reiserlab/LED-Display_G4_Hardware_Driver/driver_40mm_atmega_v1p9/assets/driver_40mm_atmega.step

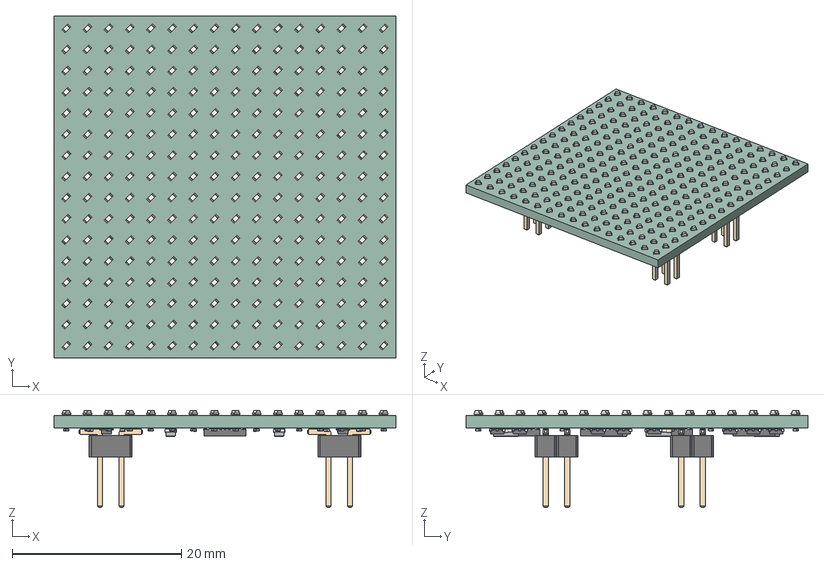
[picture p2: CAD file, 2025-07-31]
driver_40mm_atmega_v1p9/assets/driver_40mm_atmega.step
40.4 x 40.4 x 11.5 mm
LED_0402_1005Metric x 256
PinHeader_2x02_P2.54mm_Vertical_SMD x 4
QFN-32-1EP_5x5mm_P0.5mm_EP3.7x3.7mm x 4
R_0201_0603Metric x 100
SOT-563 x 16
C_0201_0603Metric x 40
Resonator_SMD_Murata_CSTxExxV-3Pin_3.0x1.1mm x 4
driver_40mm_atmega_PCB
