reiserlab/LED-Display_G4_Hardware_Driver/docs/assets/driver_40mm_atmega_v1.9_schematic.pdf

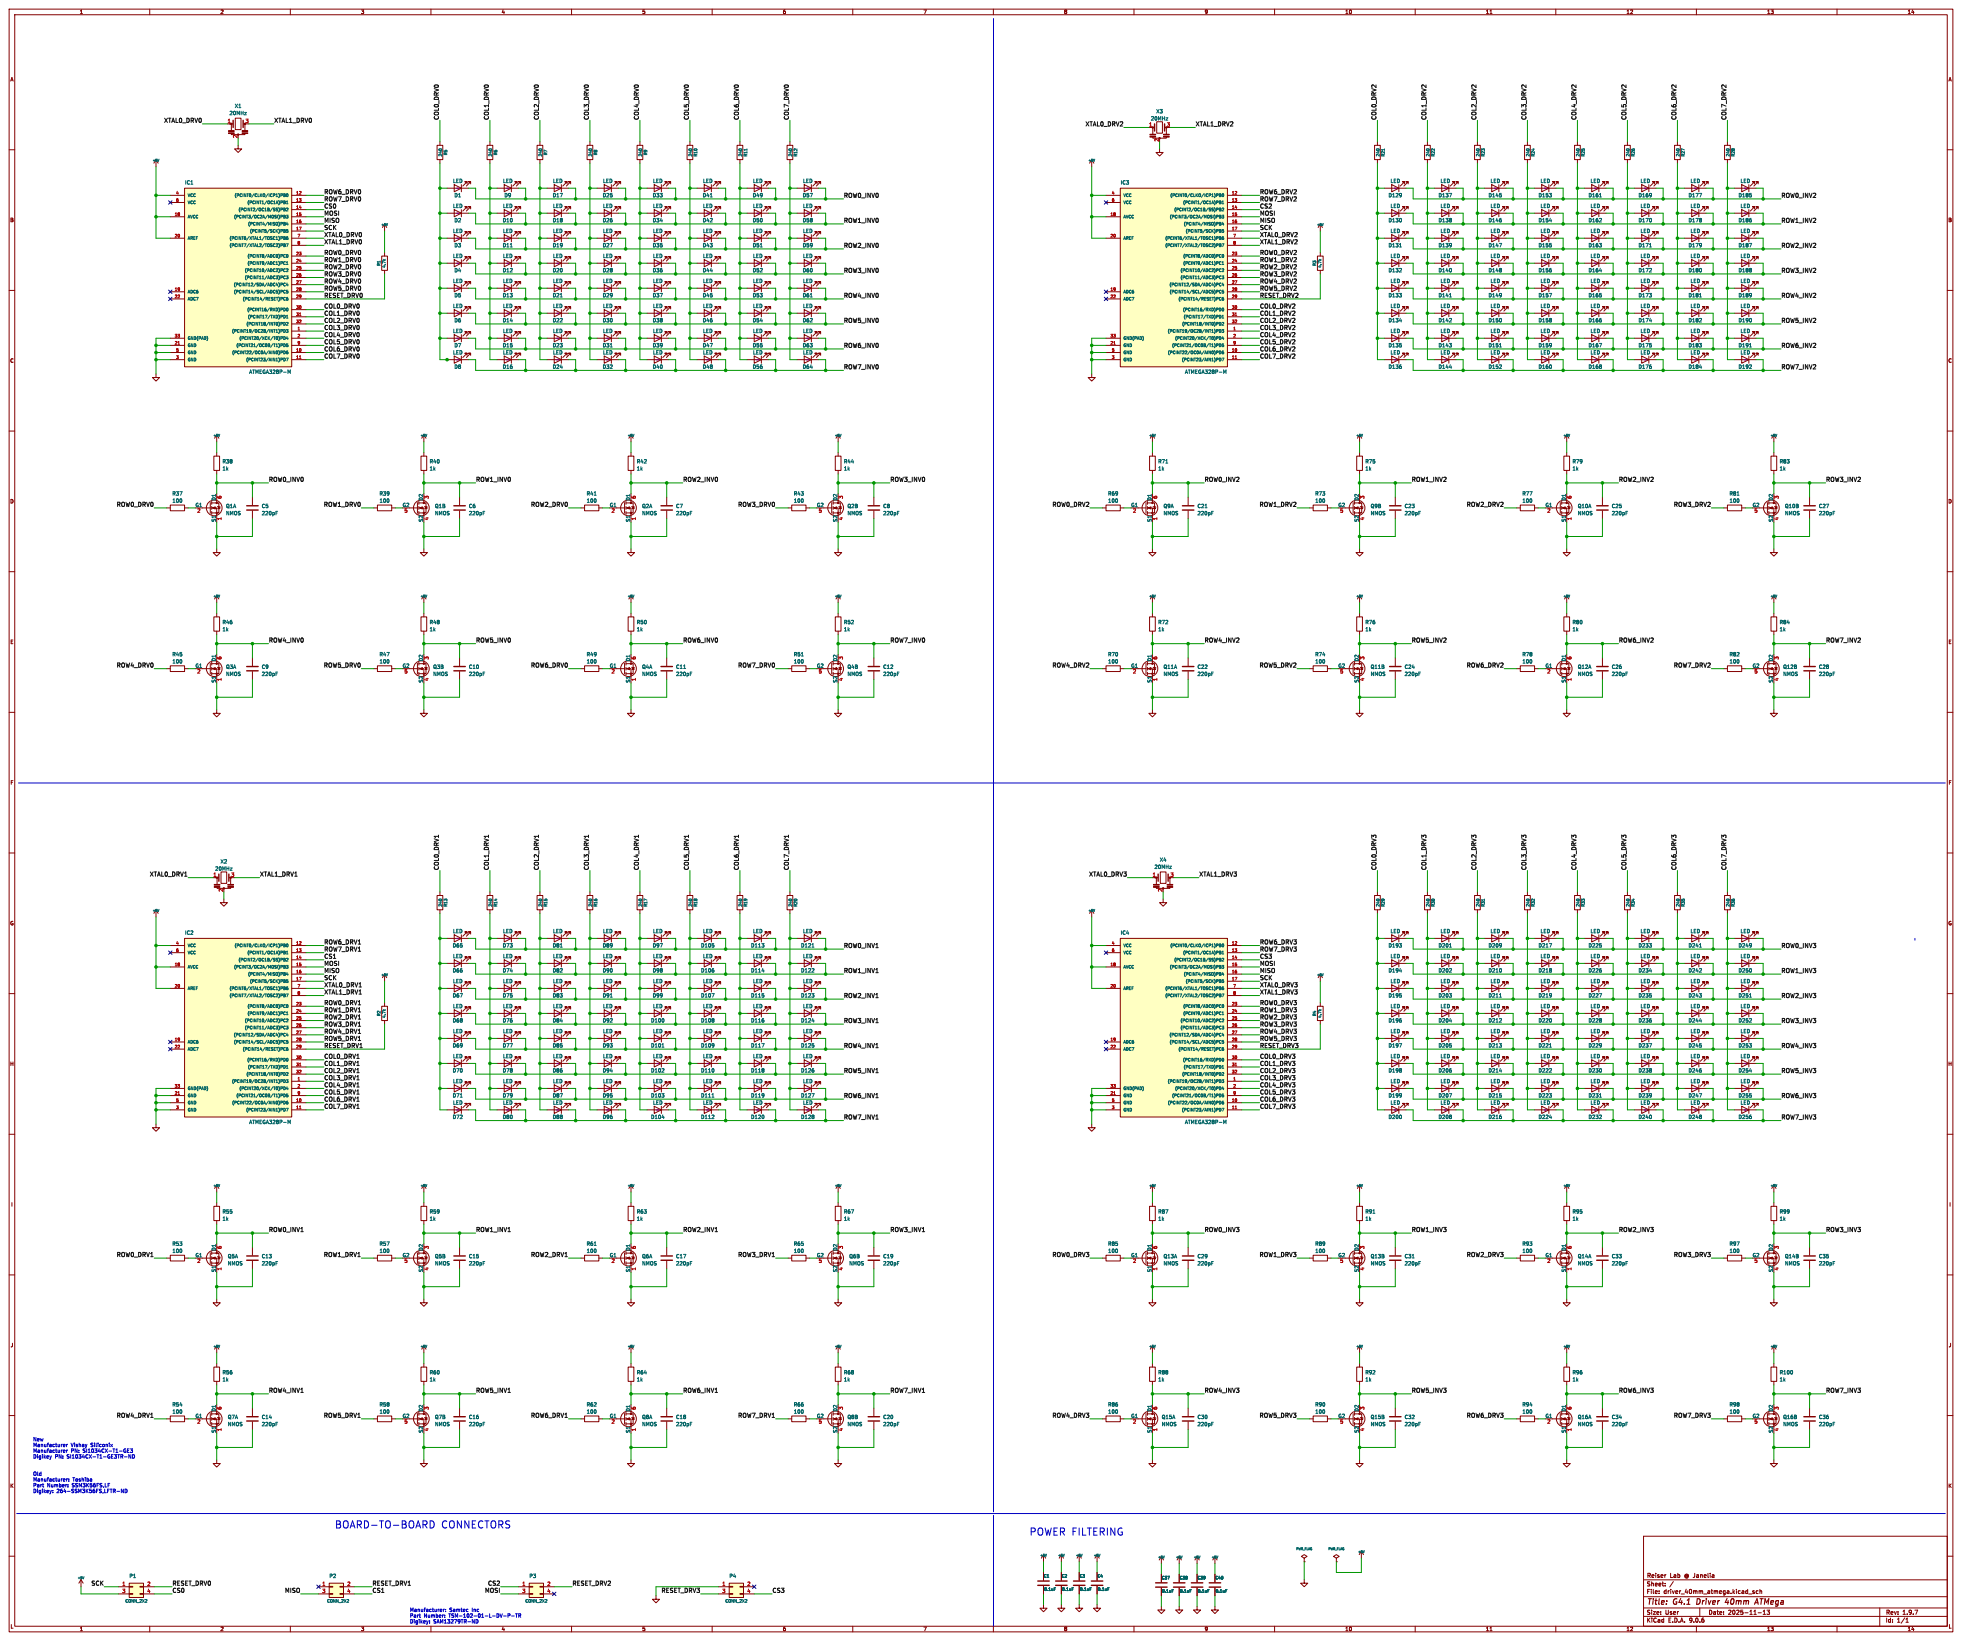
[picture p3: page 1]

Id: 1/1 Title: G4.1 Driver 40mm ATMega
