reiserlab/LED-Display_G4_Hardware_Driver/(list of files, drawings)

Other design files:
driver_40mm_atmega_v1p9/driver_40mm_atmega.dsn
