reiserlab/LED-Display_G4_Hardware_Driver/driver_40mm_atmega_v1p9/driver_40mm_atmega.kicad_pcb

## KiCad design driver_40mm_atmega_v1p9/driver_40mm_atmega.kicad_pcb (2025-11-13)

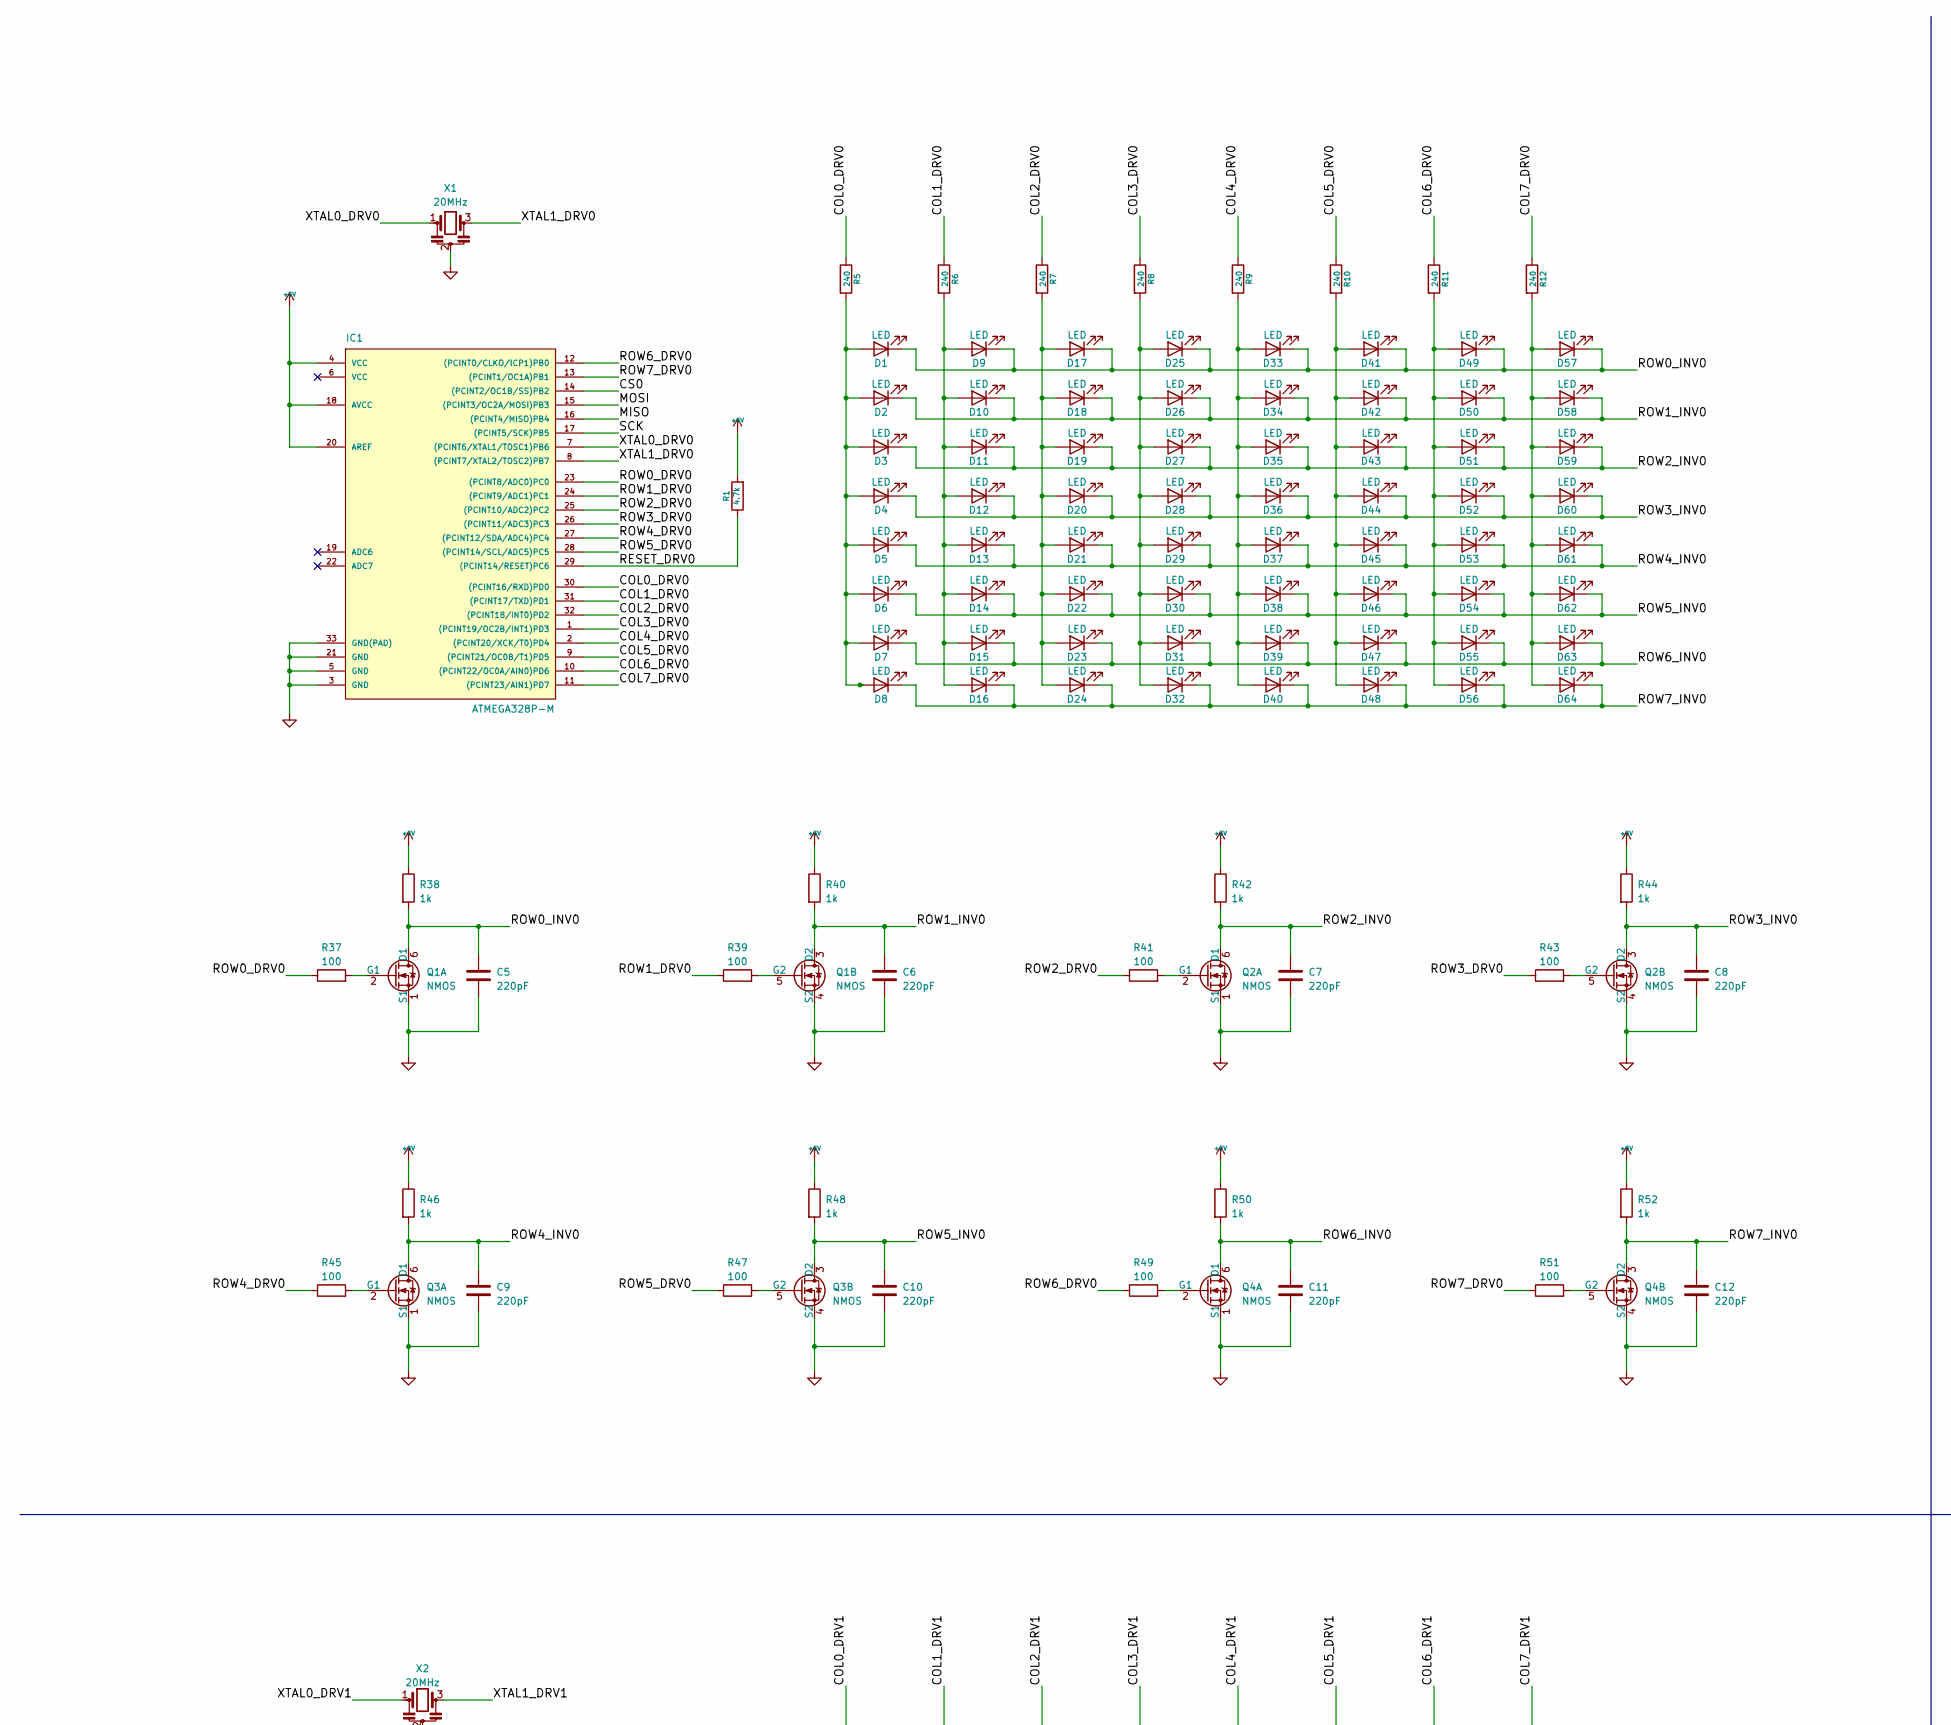
[picture p4: schematic driver_40mm_atmega.kicad_sch, G4.1 Driver 40mm ATMega, part in row 1, column 1]

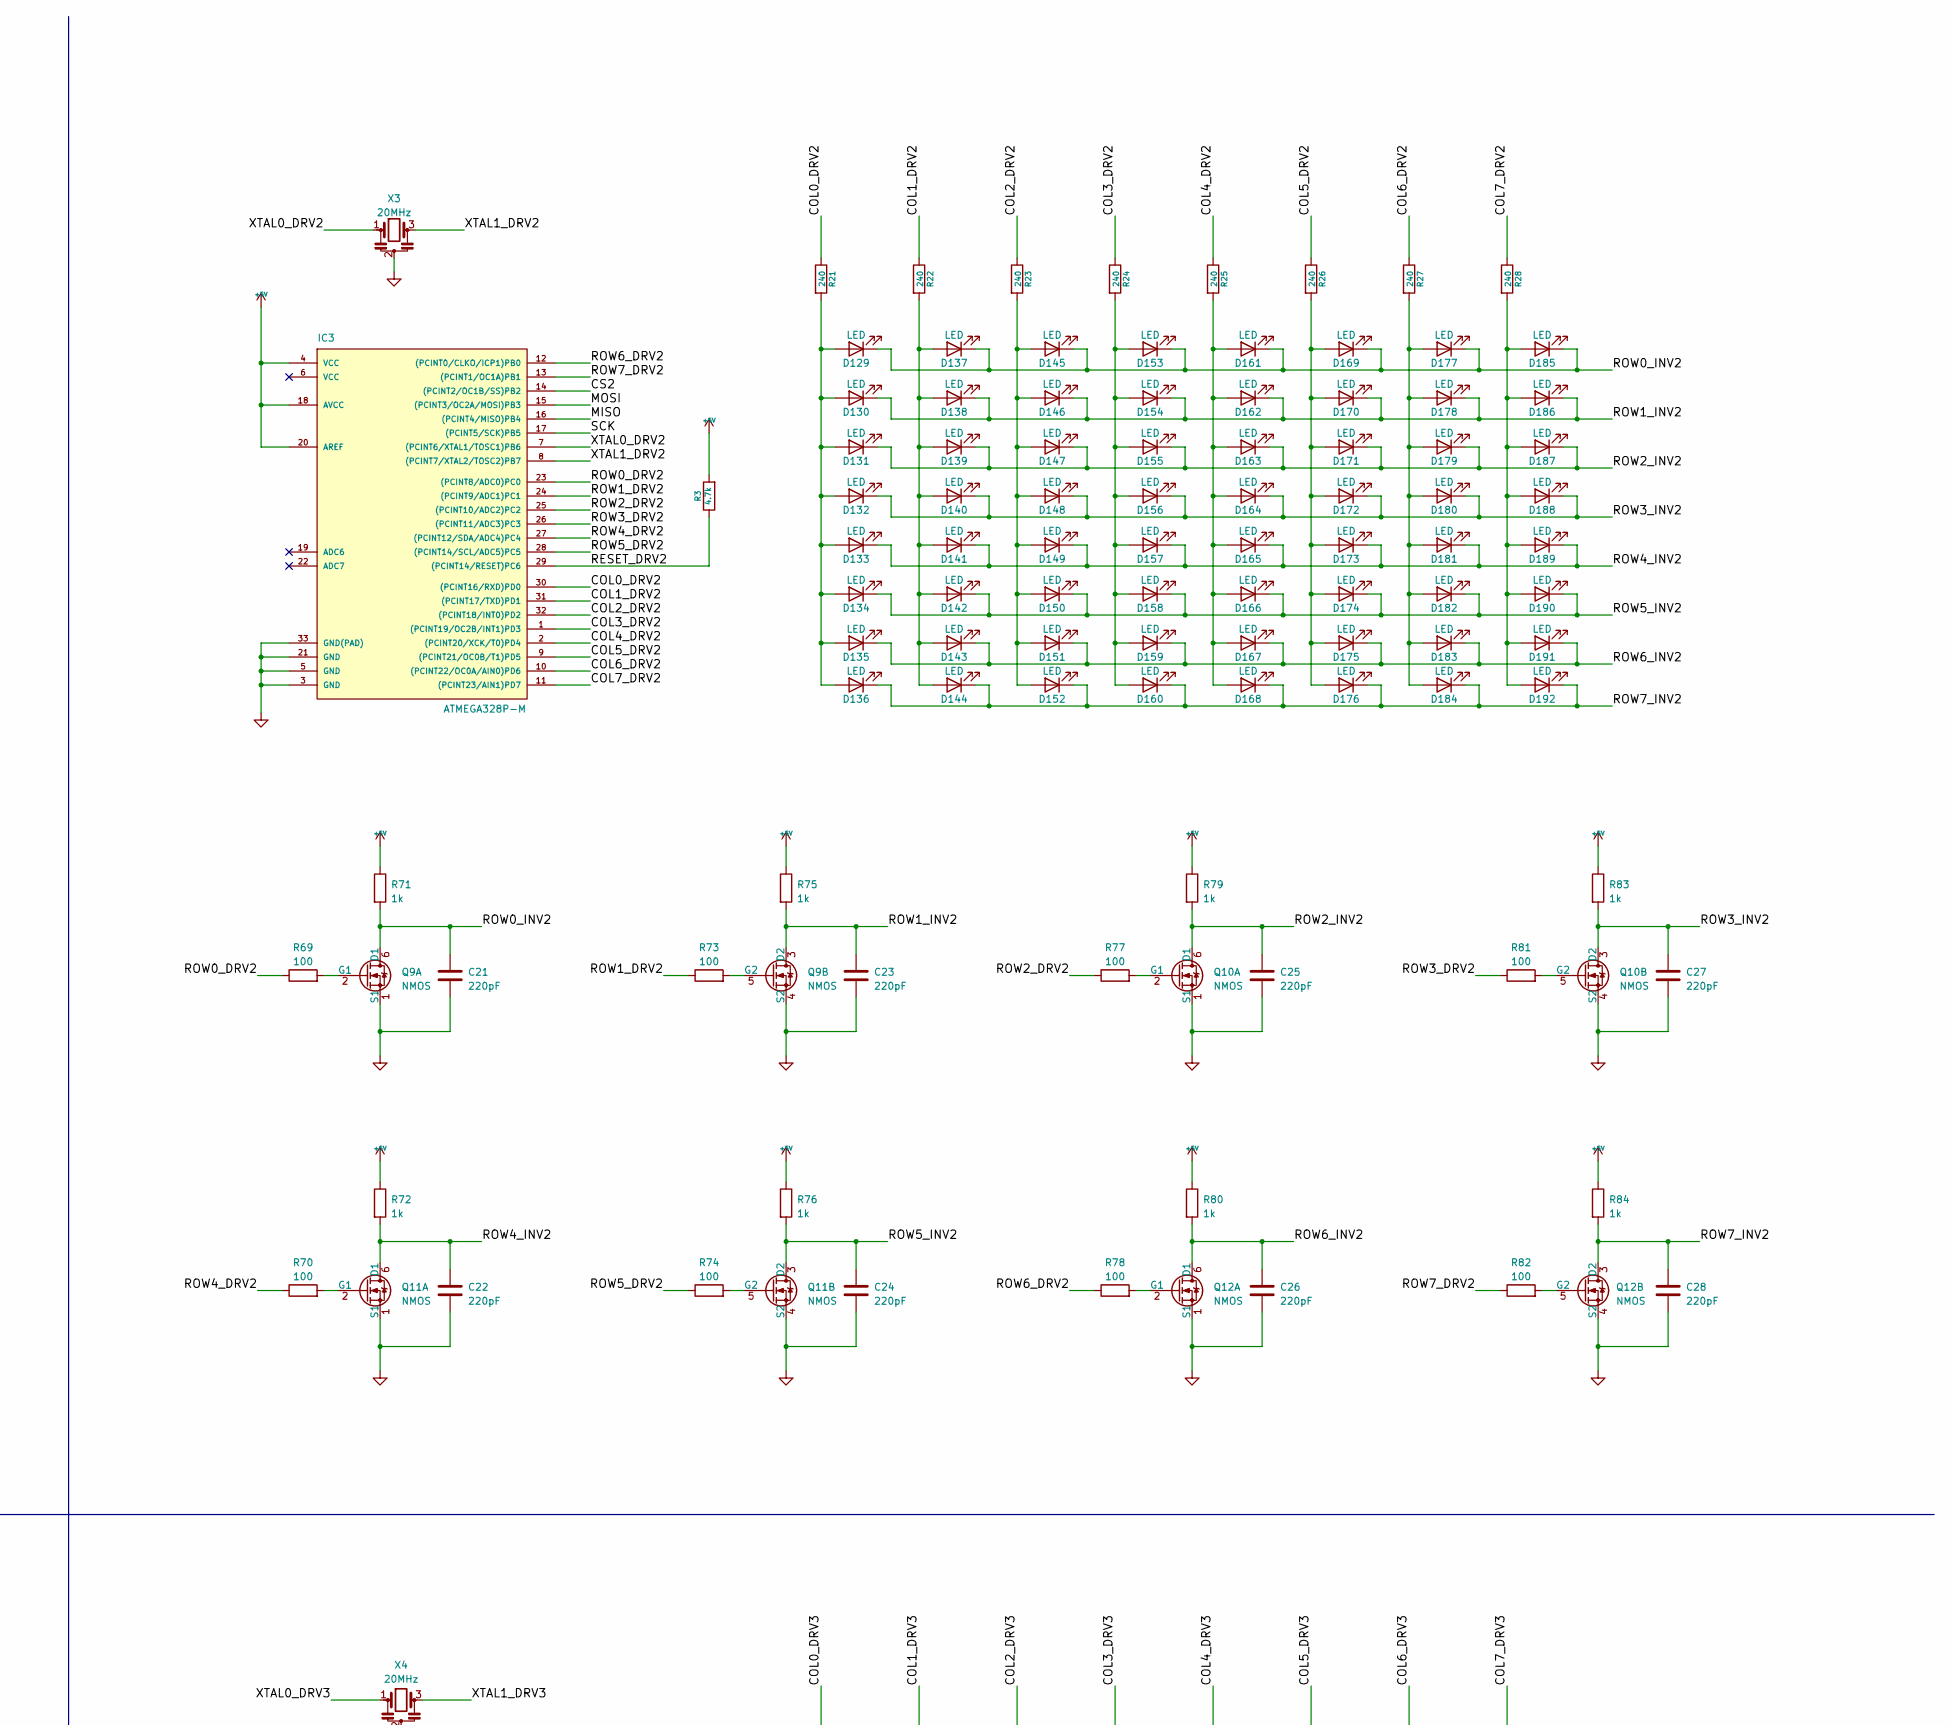
[picture p5: schematic driver_40mm_atmega.kicad_sch, G4.1 Driver 40mm ATMega, part in row 1, column 2]

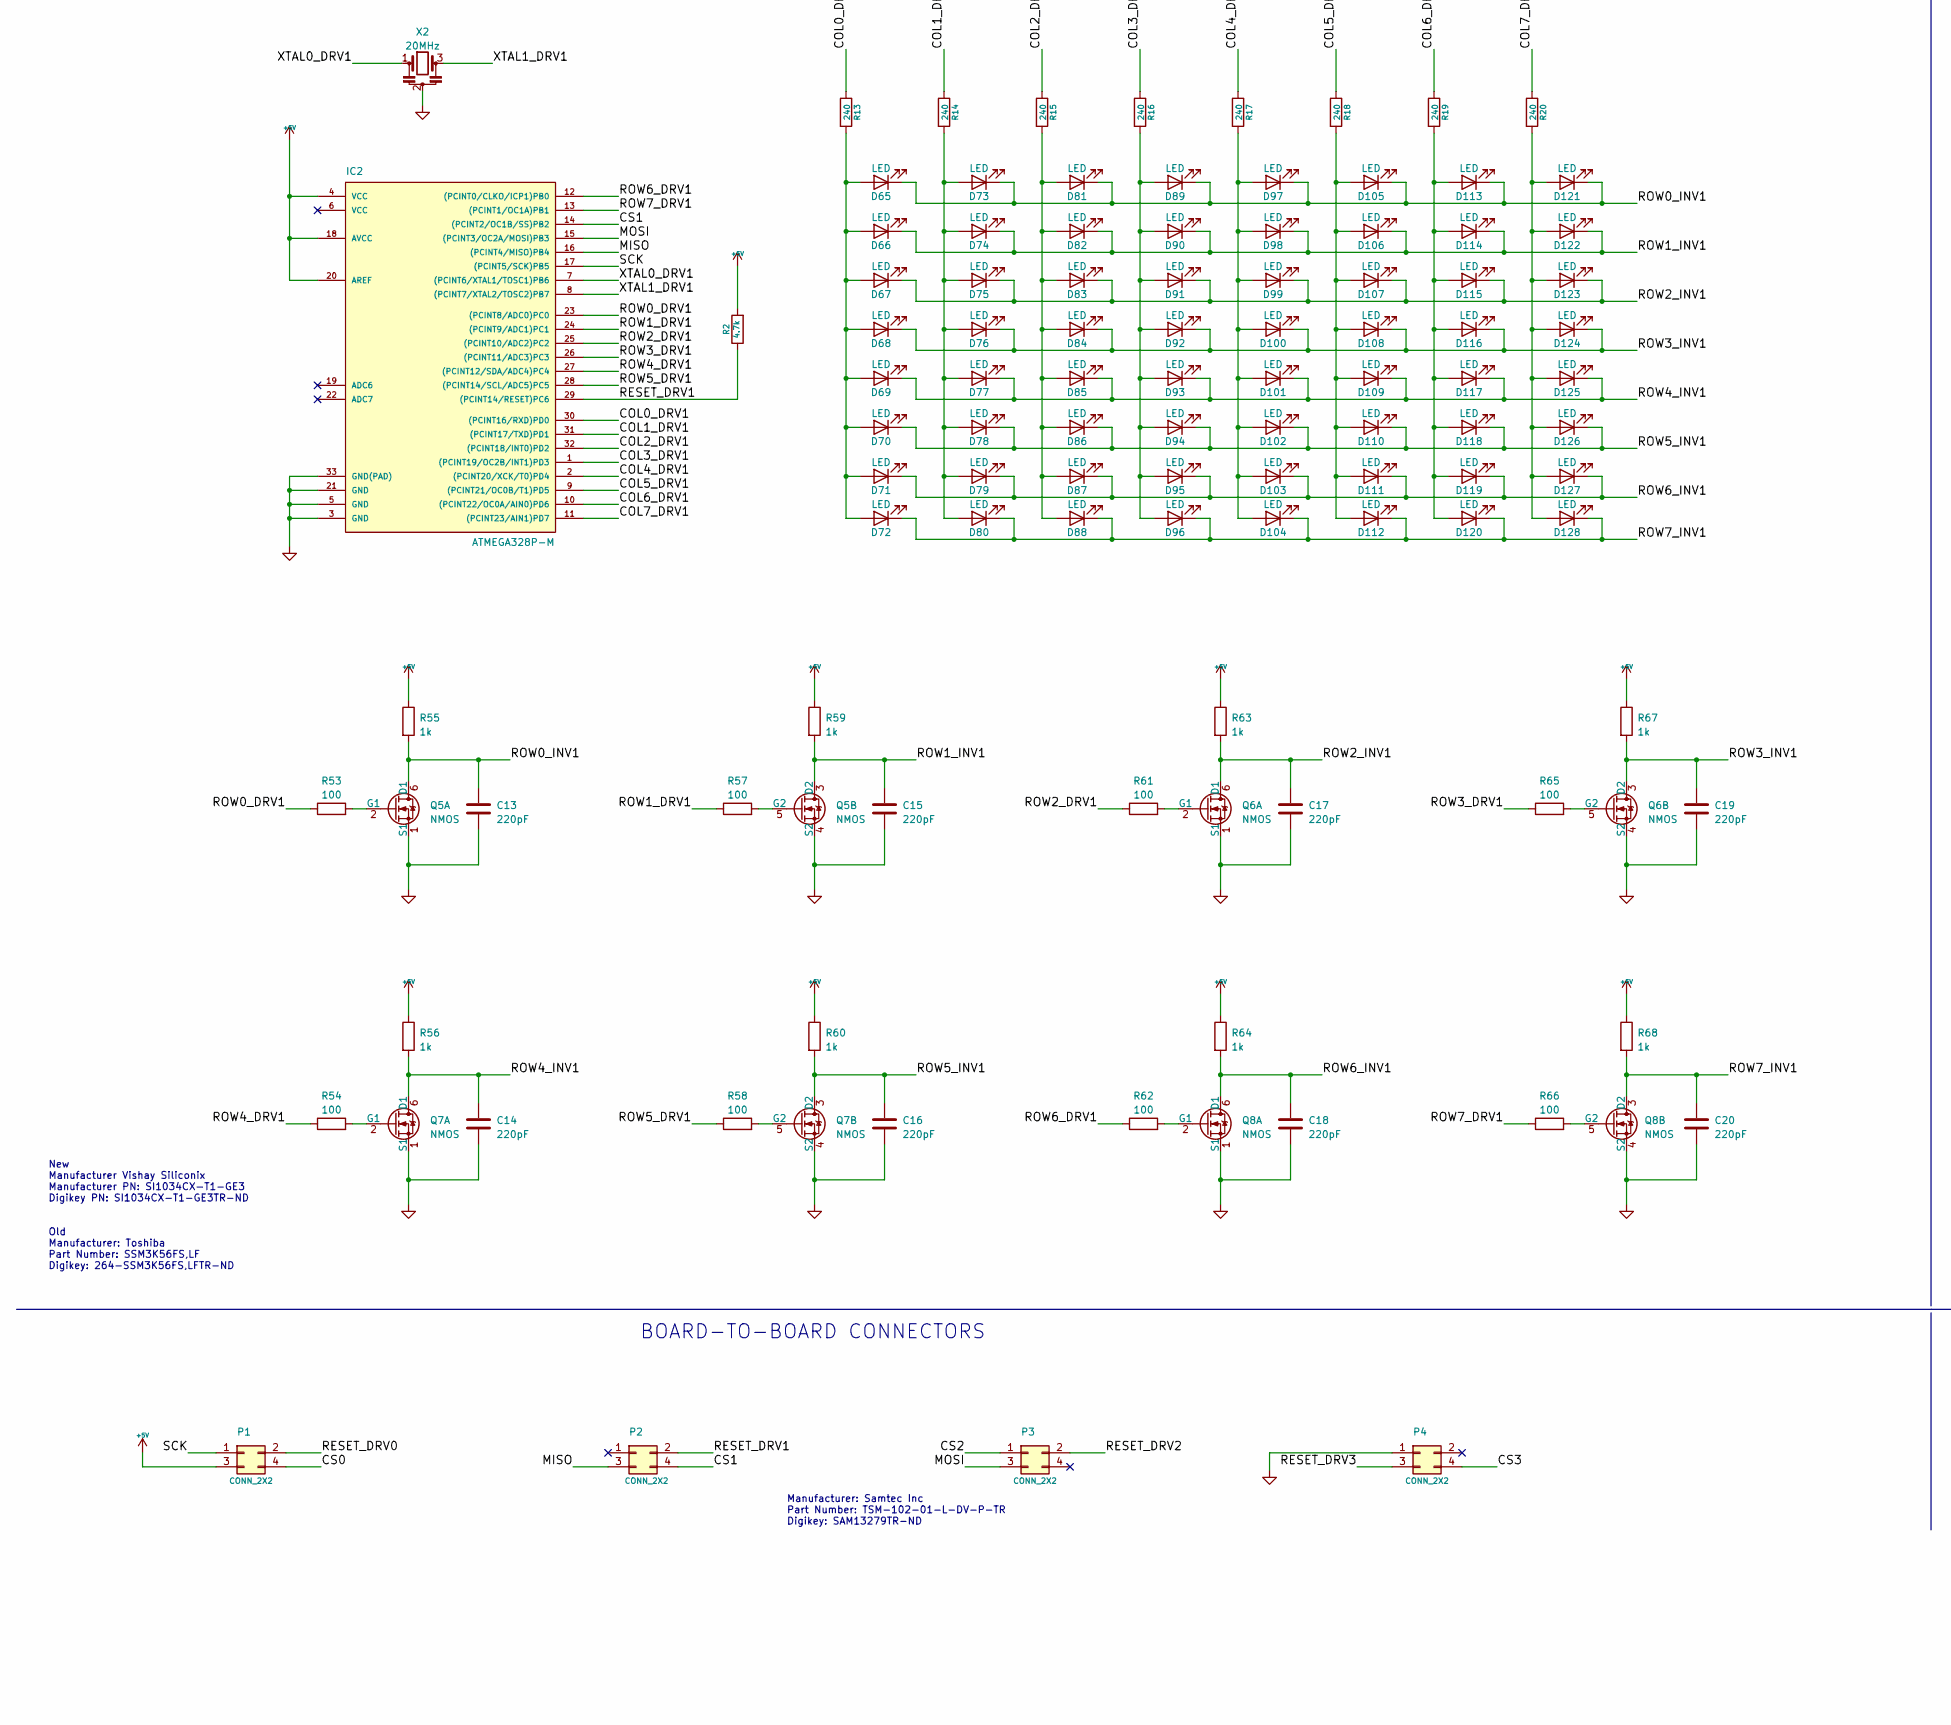
[picture p6: schematic driver_40mm_atmega.kicad_sch, G4.1 Driver 40mm ATMega, part in row 2, column 1]

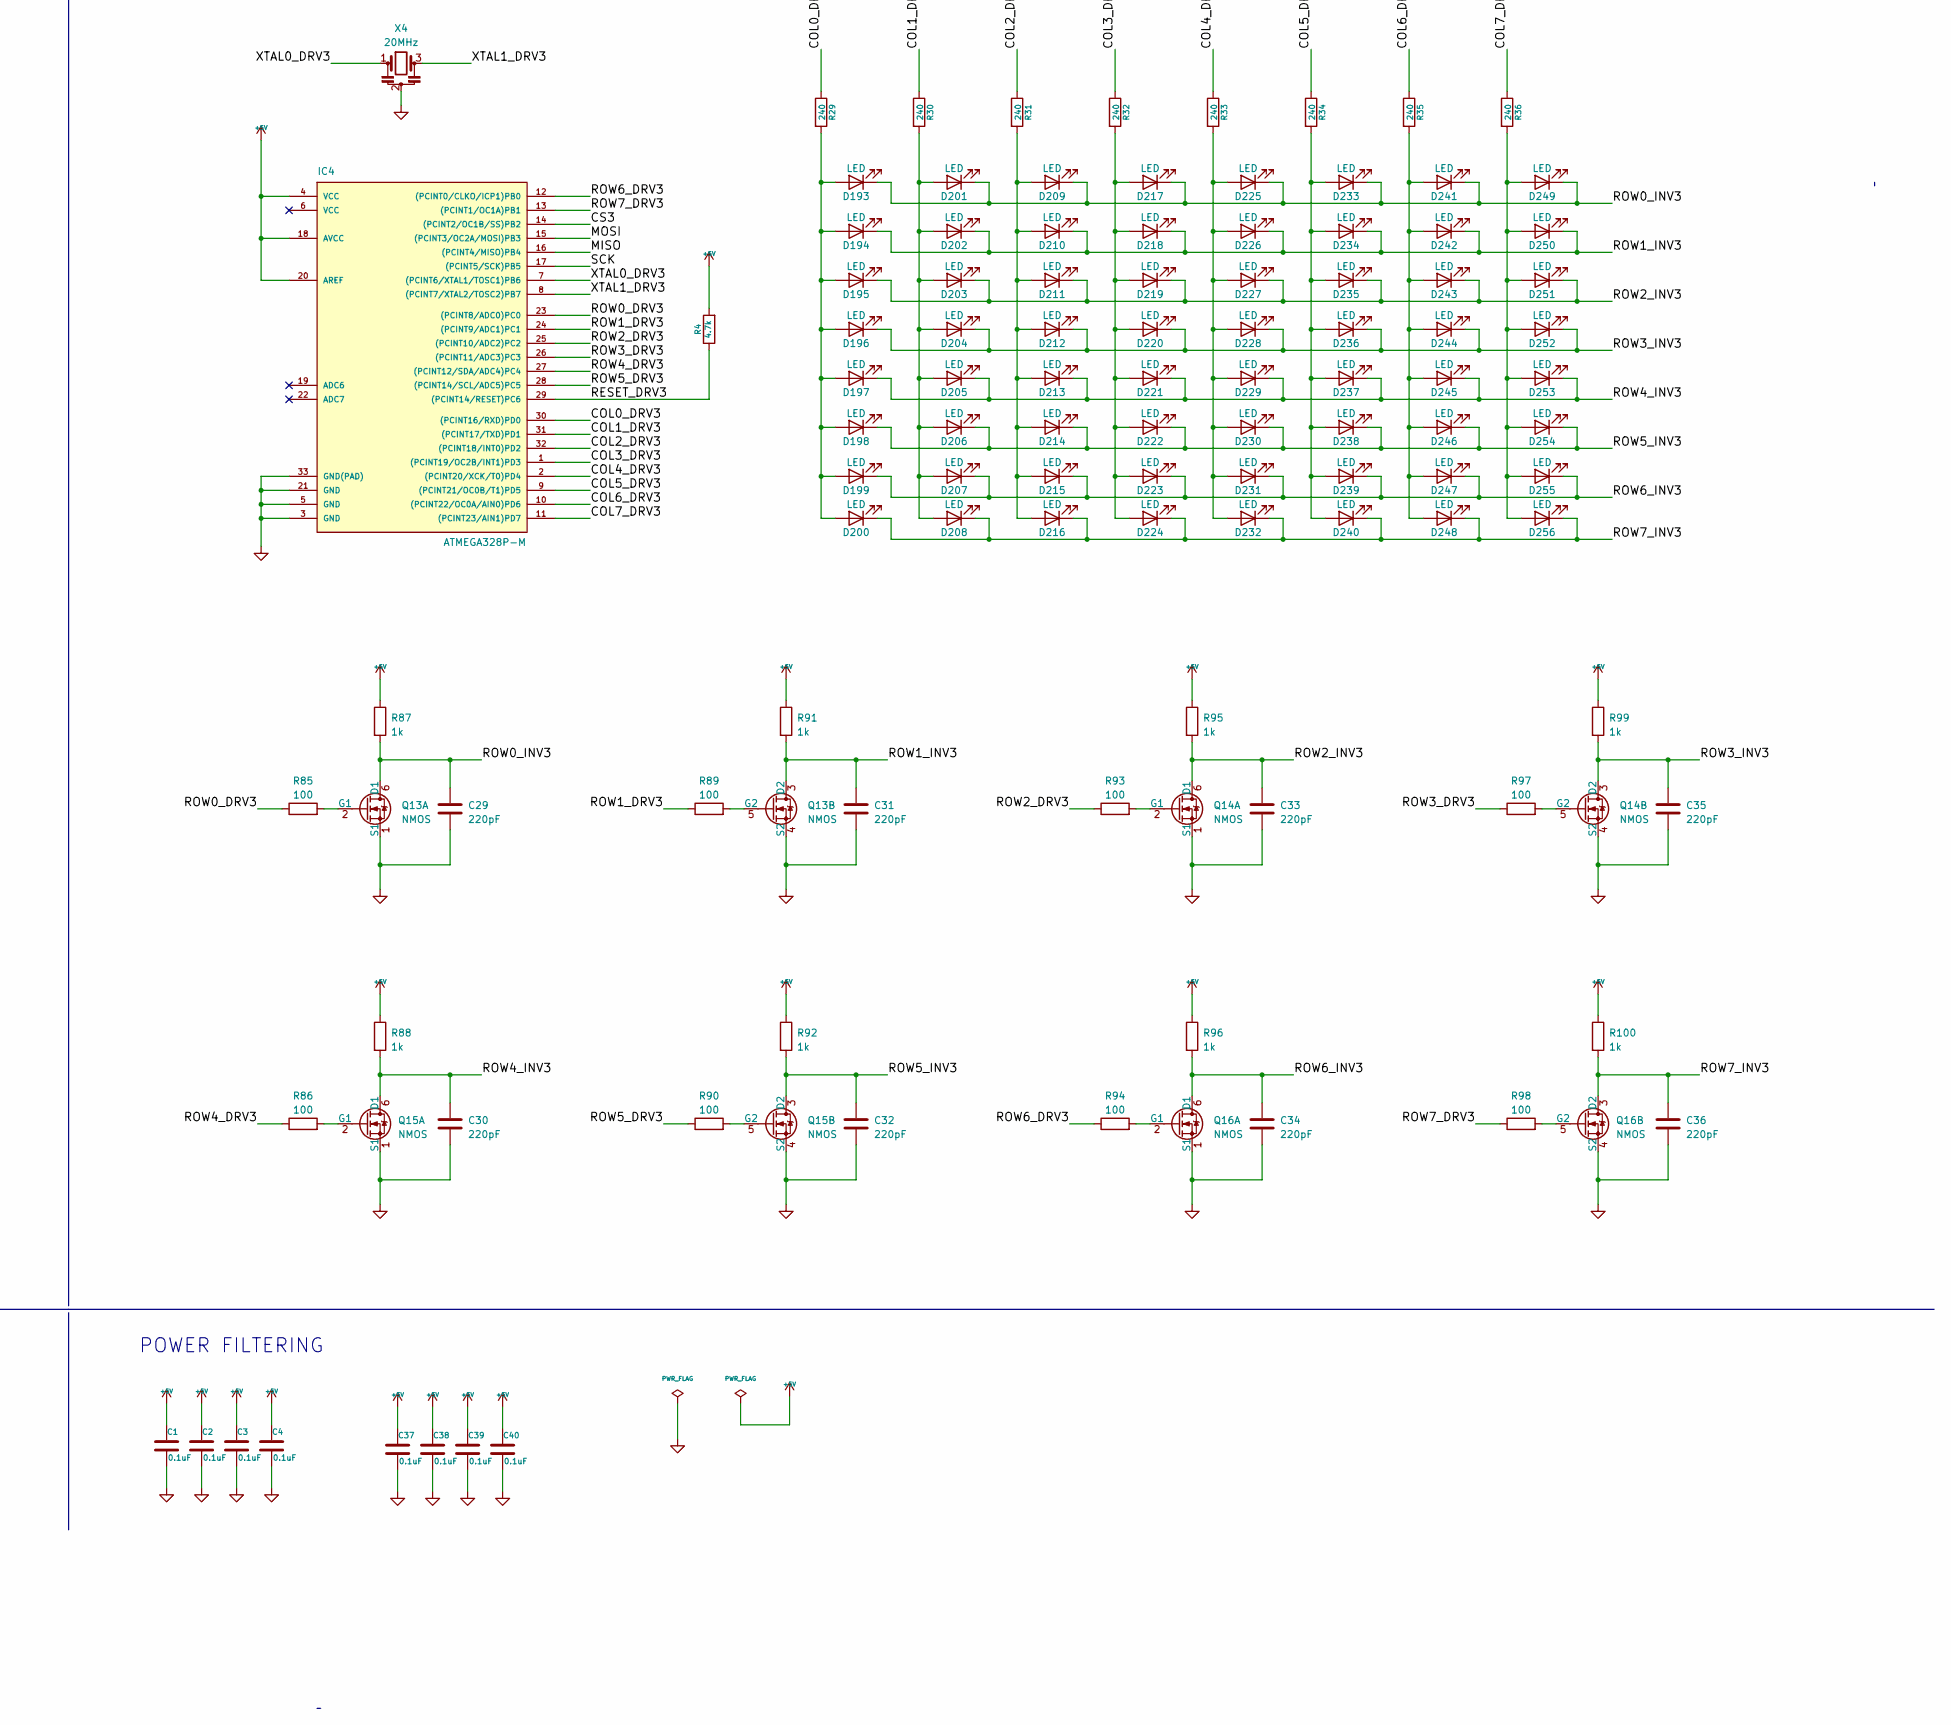
[picture p7: schematic driver_40mm_atmega.kicad_sch, G4.1 Driver 40mm ATMega, part in row 2, column 2]

Parts:
C1, C2, C3, C4, C37, C38, C39, C40: 0.1uF; C_0201_0603Metric; JLCPCB PN C76937
C5, C6, C7, C8, C9, C10, C11, C12, C13, C14, C15, C16, C17, C18, C19, C20, C21, C22, C23, C24, C25, C26, C27, C28, C29, C30, C31, C32, C33, C34, C35, C36: 220pF; C_0201_0603Metric; JLCPCB PN C281748
D1, D2, D3, D4, D5, D6, D7, D8, D9, D10, D11, D12, D13, D14, D15, D16, D17, D18, D19, D20, D21, D22, D23, D24, D25, D26, D27, D28, D29, D30, D31, D32, D33, D34, D35, D36, D37, D38, D39, D40, D41, D42, D43, D44, D45, D46, D47, D48, D49, D50, D51, D52, D53, D54, D55, D56, D57, D58, D59, D60, D61, D62, D63, D64, D65, D66, D67, D68, D69, D70, D71, D72, D73, D74, D75, D76, D77, D78, D79, D80, D81, D82, D83, D84, D85, D86, D87, D88, D89, D90, D91, D92, D93, D94, D95, D96, D97, D98, D99, D100, D101, D102, D103, D104, D105, D106, D107, D108, D109, D110, D111, D112, D113, D114, D115, D116, D117, D118, D119, D120, D121, D122, D123, D124, D125, D126, D127, D128, D129, D130, D131, D132, D133, D134, D135, D136, D137, D138, D139, D140, D141, D142, D143, D144, D145, D146, D147, D148, D149, D150, D151, D152, D153, D154, D155, D156, D157, D158, D159, D160, D161, D162, D163, D164, D165, D166, D167, D168, D169, D170, D171, D172, D173, D174, D175, D176, D177, D178, D179, D180, D181, D182, D183, D184, D185, D186, D187, D188, D189, D190, D191, D192, D193, D194, D195, D196, D197, D198, D199, D200, D201, D202, D203, D204, D205, D206, D207, D208, D209, D210, D211, D212, D213, D214, D215, D216, D217, D218, D219, D220, D221, D222, D223, D224, D225, D226, D227, D228, D229, D230, D231, D232, D233, D234, D235, D236, D237, D238, D239, D240, D241, D242, D243, D244, D245, D246, D247, D248, D249, D250, D251, D252, D253, D254, D255, D256: LED; LED_0402_1005Metric; JLCPCB PN C9900113976
IC1, IC2, IC3, IC4: ATMEGA328P-M; QFN-32-1EP_5x5mm_P0.5mm_EP3.1x3.1mm; JLCPCB PN C2651951
P1, P2, P3, P4: CONN_2X2; PinHeader_2x02_P2.54mm_Vertical_SMD; JLCPCB PN C919361
Q1, Q2, Q3, Q4, Q5, Q6, Q7, Q8, Q9, Q10, Q11, Q12, Q13, Q14, Q15, Q16: NMOS; SC-89-6; JLCPCB PN C145239
R1, R2, R3, R4: 4.7k; R_0201_0603Metric; JLCPCB PN C226669
R5, R6, R7, R8, R9, R10, R11, R12, R13, R14, R15, R16, R17, R18, R19, R20, R21, R22, R23, R24, R25, R26, R27, R28, R29, R30, R31, R32, R33, R34, R35, R36: 240; R_0201_0603Metric; JLCPCB PN C155745
R37, R39, R41, R43, R45, R47, R49, R51, R53, R54, R57, R58, R61, R62, R65, R66, R69, R70, R73, R74, R77, R78, R81, R82, R85, R86, R89, R90, R93, R94, R97, R98: 100; R_0201_0603Metric; JLCPCB PN C77623
R38, R40, R42, R44, R46, R48, R50, R52, R55, R56, R59, R60, R63, R64, R67, R68, R71, R72, R75, R76, R79, R80, R83, R84, R87, R88, R91, R92, R95, R96, R99, R100: 1k; R_0201_0603Metric; JLCPCB PN C102689
X1, X2, X3, X4: 20MHz; Resonator_SMD_Murata_CSTxExxV-3Pin_3.0x1.1mm; JLCPCB PN C882604

Connections:
+5V: C1.1, C2.1, C3.1, C4.1, C37.1, C38.1, C39.1, C40.1, IC1.4 (VCC), IC1.18 (AVCC), IC1.20 (AREF), IC2.4 (VCC), IC2.18 (AVCC), IC2.20 (AREF), IC3.4 (VCC), IC3.18 (AVCC), IC3.20 (AREF), IC4.4 (VCC), IC4.18 (AVCC), IC4.20 (AREF), P1.3, R1.2, R2.2, R3.2, R4.2, R38.1, R40.1, R42.1, R44.1, R46.1, R48.1, R50.1, R52.1, R55.1, R56.1, R59.1, R60.1, R63.1, R64.1, R67.1, R68.1, R71.1, R72.1, R75.1, R76.1, R79.1, R80.1, R83.1, R84.1, R87.1, R88.1, R91.1, R92.1, R95.1, R96.1, R99.1, R100.1
/COL0_DRV0: IC1.30 ((PCINT16/RXD)PD0), R5.1
/COL0_DRV1: IC2.30 ((PCINT16/RXD)PD0), R13.1
/COL0_DRV2: IC3.30 ((PCINT16/RXD)PD0), R21.1
/COL0_DRV3: IC4.30 ((PCINT16/RXD)PD0), R29.1
/COL1_DRV0: IC1.31 ((PCINT17/TXD)PD1), R6.1
/COL1_DRV1: IC2.31 ((PCINT17/TXD)PD1), R14.1
/COL1_DRV2: IC3.31 ((PCINT17/TXD)PD1), R22.1
/COL1_DRV3: IC4.31 ((PCINT17/TXD)PD1), R30.1
/COL2_DRV0: IC1.32 ((PCINT18/INT0)PD2), R7.1
/COL2_DRV1: IC2.32 ((PCINT18/INT0)PD2), R15.1
/COL2_DRV2: IC3.32 ((PCINT18/INT0)PD2), R23.1
/COL2_DRV3: IC4.32 ((PCINT18/INT0)PD2), R31.1
/COL3_DRV0: IC1.1 ((PCINT19/OC2B/INT1)PD3), R8.1
/COL3_DRV1: IC2.1 ((PCINT19/OC2B/INT1)PD3), R16.1
/COL3_DRV2: IC3.1 ((PCINT19/OC2B/INT1)PD3), R24.1
/COL3_DRV3: IC4.1 ((PCINT19/OC2B/INT1)PD3), R32.1
/COL4_DRV0: IC1.2 ((PCINT20/XCK/T0)PD4), R9.1
/COL4_DRV1: IC2.2 ((PCINT20/XCK/T0)PD4), R17.1
/COL4_DRV2: IC3.2 ((PCINT20/XCK/T0)PD4), R25.1
/COL4_DRV3: IC4.2 ((PCINT20/XCK/T0)PD4), R33.1
/COL5_DRV0: IC1.9 ((PCINT21/OC0B/T1)PD5), R10.1
/COL5_DRV1: IC2.9 ((PCINT21/OC0B/T1)PD5), R18.1
/COL5_DRV2: IC3.9 ((PCINT21/OC0B/T1)PD5), R26.1
/COL5_DRV3: IC4.9 ((PCINT21/OC0B/T1)PD5), R34.1
/COL6_DRV0: IC1.10 ((PCINT22/OC0A/AIN0)PD6), R11.1
/COL6_DRV1: IC2.10 ((PCINT22/OC0A/AIN0)PD6), R19.1
/COL6_DRV2: IC3.10 ((PCINT22/OC0A/AIN0)PD6), R27.1
/COL6_DRV3: IC4.10 ((PCINT22/OC0A/AIN0)PD6), R35.1
/COL7_DRV0: IC1.11 ((PCINT23/AIN1)PD7), R12.1
/COL7_DRV1: IC2.11 ((PCINT23/AIN1)PD7), R20.1
/COL7_DRV2: IC3.11 ((PCINT23/AIN1)PD7), R28.1
/COL7_DRV3: IC4.11 ((PCINT23/AIN1)PD7), R36.1
/CS0: IC1.14 ((PCINT2/OC1B/SS)PB2), P1.4
/CS1: IC2.14 ((PCINT2/OC1B/SS)PB2), P2.4
/CS2: IC3.14 ((PCINT2/OC1B/SS)PB2), P3.1
/CS3: IC4.14 ((PCINT2/OC1B/SS)PB2), P4.4
/MISO: IC1.16 ((PCINT4/MISO)PB4), IC2.16 ((PCINT4/MISO)PB4), IC3.16 ((PCINT4/MISO)PB4), IC4.16 ((PCINT4/MISO)PB4), P2.3
/MOSI: IC1.15 ((PCINT3/OC2A/MOSI)PB3), IC2.15 ((PCINT3/OC2A/MOSI)PB3), IC3.15 ((PCINT3/OC2A/MOSI)PB3), IC4.15 ((PCINT3/OC2A/MOSI)PB3), P3.3
/RESET_DRV0: IC1.29 ((PCINT14/RESET)PC6), P1.2, R1.1
/RESET_DRV1: IC2.29 ((PCINT14/RESET)PC6), P2.2, R2.1
/RESET_DRV2: IC3.29 ((PCINT14/RESET)PC6), P3.2, R3.1
/RESET_DRV3: IC4.29 ((PCINT14/RESET)PC6), P4.3, R4.1
/ROW0_DRV0: IC1.23 ((PCINT8/ADC0)PC0), R37.1
/ROW0_DRV1: IC2.23 ((PCINT8/ADC0)PC0), R53.1
/ROW0_DRV2: IC3.23 ((PCINT8/ADC0)PC0), R69.1
/ROW0_DRV3: IC4.23 ((PCINT8/ADC0)PC0), R85.1
/ROW0_INV0: C5.1, D1.1 (K), D9.1 (K), D17.1 (K), D25.1 (K), D33.1 (K), D41.1 (K), D49.1 (K), D57.1 (K), Q1.6 (D1), R38.2
/ROW0_INV1: C13.1, D65.1 (K), D73.1 (K), D81.1 (K), D89.1 (K), D97.1 (K), D105.1 (K), D113.1 (K), D121.1 (K), Q5.6 (D1), R55.2
/ROW0_INV2: C21.1, D129.1 (K), D137.1 (K), D145.1 (K), D153.1 (K), D161.1 (K), D169.1 (K), D177.1 (K), D185.1 (K), Q9.6 (D1), R71.2
/ROW0_INV3: C29.1, D193.1 (K), D201.1 (K), D209.1 (K), D217.1 (K), D225.1 (K), D233.1 (K), D241.1 (K), D249.1 (K), Q13.6 (D1), R87.2
/ROW1_DRV0: IC1.24 ((PCINT9/ADC1)PC1), R39.1
/ROW1_DRV1: IC2.24 ((PCINT9/ADC1)PC1), R57.1
/ROW1_DRV2: IC3.24 ((PCINT9/ADC1)PC1), R73.1
/ROW1_DRV3: IC4.24 ((PCINT9/ADC1)PC1), R89.1
/ROW1_INV0: C6.1, D2.1 (K), D10.1 (K), D18.1 (K), D26.1 (K), D34.1 (K), D42.1 (K), D50.1 (K), D58.1 (K), Q1.3 (D2), R40.2
/ROW1_INV1: C15.1, D66.1 (K), D74.1 (K), D82.1 (K), D90.1 (K), D98.1 (K), D106.1 (K), D114.1 (K), D122.1 (K), Q5.3 (D2), R59.2
/ROW1_INV2: C23.1, D130.1 (K), D138.1 (K), D146.1 (K), D154.1 (K), D162.1 (K), D170.1 (K), D178.1 (K), D186.1 (K), Q9.3 (D2), R75.2
/ROW1_INV3: C31.1, D194.1 (K), D202.1 (K), D210.1 (K), D218.1 (K), D226.1 (K), D234.1 (K), D242.1 (K), D250.1 (K), Q13.3 (D2), R91.2
/ROW2_DRV0: IC1.25 ((PCINT10/ADC2)PC2), R41.1
/ROW2_DRV1: IC2.25 ((PCINT10/ADC2)PC2), R61.1
/ROW2_DRV2: IC3.25 ((PCINT10/ADC2)PC2), R77.1
/ROW2_DRV3: IC4.25 ((PCINT10/ADC2)PC2), R93.1
/ROW2_INV0: C7.1, D3.1 (K), D11.1 (K), D19.1 (K), D27.1 (K), D35.1 (K), D43.1 (K), D51.1 (K), D59.1 (K), Q2.6 (D1), R42.2
/ROW2_INV1: C17.1, D67.1 (K), D75.1 (K), D83.1 (K), D91.1 (K), D99.1 (K), D107.1 (K), D115.1 (K), D123.1 (K), Q6.6 (D1), R63.2
/ROW2_INV2: C25.1, D131.1 (K), D139.1 (K), D147.1 (K), D155.1 (K), D163.1 (K), D171.1 (K), D179.1 (K), D187.1 (K), Q10.6 (D1), R79.2
/ROW2_INV3: C33.1, D195.1 (K), D203.1 (K), D211.1 (K), D219.1 (K), D227.1 (K), D235.1 (K), D243.1 (K), D251.1 (K), Q14.6 (D1), R95.2
/ROW3_DRV0: IC1.26 ((PCINT11/ADC3)PC3), R43.1
/ROW3_DRV1: IC2.26 ((PCINT11/ADC3)PC3), R65.1
/ROW3_DRV2: IC3.26 ((PCINT11/ADC3)PC3), R81.1
/ROW3_DRV3: IC4.26 ((PCINT11/ADC3)PC3), R97.1
/ROW3_INV0: C8.1, D4.1 (K), D12.1 (K), D20.1 (K), D28.1 (K), D36.1 (K), D44.1 (K), D52.1 (K), D60.1 (K), Q2.3 (D2), R44.2
/ROW3_INV1: C19.1, D68.1 (K), D76.1 (K), D84.1 (K), D92.1 (K), D100.1 (K), D108.1 (K), D116.1 (K), D124.1 (K), Q6.3 (D2), R67.2
/ROW3_INV2: C27.1, D132.1 (K), D140.1 (K), D148.1 (K), D156.1 (K), D164.1 (K), D172.1 (K), D180.1 (K), D188.1 (K), Q10.3 (D2), R83.2
/ROW3_INV3: C35.1, D196.1 (K), D204.1 (K), D212.1 (K), D220.1 (K), D228.1 (K), D236.1 (K), D244.1 (K), D252.1 (K), Q14.3 (D2), R99.2
/ROW4_DRV0: IC1.27 ((PCINT12/SDA/ADC4)PC4), R45.1
/ROW4_DRV1: IC2.27 ((PCINT12/SDA/ADC4)PC4), R54.1
/ROW4_DRV2: IC3.27 ((PCINT12/SDA/ADC4)PC4), R70.1
/ROW4_DRV3: IC4.27 ((PCINT12/SDA/ADC4)PC4), R86.1
/ROW4_INV0: C9.1, D5.1 (K), D13.1 (K), D21.1 (K), D29.1 (K), D37.1 (K), D45.1 (K), D53.1 (K), D61.1 (K), Q3.6 (D1), R46.2
/ROW4_INV1: C14.1, D69.1 (K), D77.1 (K), D85.1 (K), D93.1 (K), D101.1 (K), D109.1 (K), D117.1 (K), D125.1 (K), Q7.6 (D1), R56.2
/ROW4_INV2: C22.1, D133.1 (K), D141.1 (K), D149.1 (K), D157.1 (K), D165.1 (K), D173.1 (K), D181.1 (K), D189.1 (K), Q11.6 (D1), R72.2
/ROW4_INV3: C30.1, D197.1 (K), D205.1 (K), D213.1 (K), D221.1 (K), D229.1 (K), D237.1 (K), D245.1 (K), D253.1 (K), Q15.6 (D1), R88.2
/ROW5_DRV0: IC1.28 ((PCINT14/SCL/ADC5)PC5), R47.1
/ROW5_DRV1: IC2.28 ((PCINT14/SCL/ADC5)PC5), R58.1
/ROW5_DRV2: IC3.28 ((PCINT14/SCL/ADC5)PC5), R74.1
/ROW5_DRV3: IC4.28 ((PCINT14/SCL/ADC5)PC5), R90.1
/ROW5_INV0: C10.1, D6.1 (K), D14.1 (K), D22.1 (K), D30.1 (K), D38.1 (K), D46.1 (K), D54.1 (K), D62.1 (K), Q3.3 (D2), R48.2
/ROW5_INV1: C16.1, D70.1 (K), D78.1 (K), D86.1 (K), D94.1 (K), D102.1 (K), D110.1 (K), D118.1 (K), D126.1 (K), Q7.3 (D2), R60.2
/ROW5_INV2: C24.1, D134.1 (K), D142.1 (K), D150.1 (K), D158.1 (K), D166.1 (K), D174.1 (K), D182.1 (K), D190.1 (K), Q11.3 (D2), R76.2
/ROW5_INV3: C32.1, D198.1 (K), D206.1 (K), D214.1 (K), D222.1 (K), D230.1 (K), D238.1 (K), D246.1 (K), D254.1 (K), Q15.3 (D2), R92.2
/ROW6_DRV0: IC1.12 ((PCINT0/CLKO/ICP1)PB0), R49.1
/ROW6_DRV1: IC2.12 ((PCINT0/CLKO/ICP1)PB0), R62.1
/ROW6_DRV2: IC3.12 ((PCINT0/CLKO/ICP1)PB0), R78.1
/ROW6_DRV3: IC4.12 ((PCINT0/CLKO/ICP1)PB0), R94.1
/ROW6_INV0: C11.1, D7.1 (K), D15.1 (K), D23.1 (K), D31.1 (K), D39.1 (K), D47.1 (K), D55.1 (K), D63.1 (K), Q4.6 (D1), R50.2
/ROW6_INV1: C18.1, D71.1 (K), D79.1 (K), D87.1 (K), D95.1 (K), D103.1 (K), D111.1 (K), D119.1 (K), D127.1 (K), Q8.6 (D1), R64.2
/ROW6_INV2: C26.1, D135.1 (K), D143.1 (K), D151.1 (K), D159.1 (K), D167.1 (K), D175.1 (K), D183.1 (K), D191.1 (K), Q12.6 (D1), R80.2
/ROW6_INV3: C34.1, D199.1 (K), D207.1 (K), D215.1 (K), D223.1 (K), D231.1 (K), D239.1 (K), D247.1 (K), D255.1 (K), Q16.6 (D1), R96.2
/ROW7_DRV0: IC1.13 ((PCINT1/OC1A)PB1), R51.1
/ROW7_DRV1: IC2.13 ((PCINT1/OC1A)PB1), R66.1
/ROW7_DRV2: IC3.13 ((PCINT1/OC1A)PB1), R82.1
/ROW7_DRV3: IC4.13 ((PCINT1/OC1A)PB1), R98.1
/ROW7_INV0: C12.1, D8.1 (K), D16.1 (K), D24.1 (K), D32.1 (K), D40.1 (K), D48.1 (K), D56.1 (K), D64.1 (K), Q4.3 (D2), R52.2
/ROW7_INV1: C20.1, D72.1 (K), D80.1 (K), D88.1 (K), D96.1 (K), D104.1 (K), D112.1 (K), D120.1 (K), D128.1 (K), Q8.3 (D2), R68.2
/ROW7_INV2: C28.1, D136.1 (K), D144.1 (K), D152.1 (K), D160.1 (K), D168.1 (K), D176.1 (K), D184.1 (K), D192.1 (K), Q12.3 (D2), R84.2
/ROW7_INV3: C36.1, D200.1 (K), D208.1 (K), D216.1 (K), D224.1 (K), D232.1 (K), D240.1 (K), D248.1 (K), D256.1 (K), Q16.3 (D2), R100.2
/SCK: IC1.17 ((PCINT5/SCK)PB5), IC2.17 ((PCINT5/SCK)PB5), IC3.17 ((PCINT5/SCK)PB5), IC4.17 ((PCINT5/SCK)PB5), P1.1
/XTAL0_DRV0: IC1.7 ((PCINT6/XTAL1/TOSC1)PB6), X1.1
/XTAL0_DRV1: IC2.7 ((PCINT6/XTAL1/TOSC1)PB6), X2.1
/XTAL0_DRV2: IC3.7 ((PCINT6/XTAL1/TOSC1)PB6), X3.1
/XTAL0_DRV3: IC4.7 ((PCINT6/XTAL1/TOSC1)PB6), X4.1
/XTAL1_DRV0: IC1.8 ((PCINT7/XTAL2/TOSC2)PB7), X1.3
/XTAL1_DRV1: IC2.8 ((PCINT7/XTAL2/TOSC2)PB7), X2.3
/XTAL1_DRV2: IC3.8 ((PCINT7/XTAL2/TOSC2)PB7), X3.3
/XTAL1_DRV3: IC4.8 ((PCINT7/XTAL2/TOSC2)PB7), X4.3
GND: C1.2, C2.2, C3.2, C4.2, C5.2, C6.2, C7.2, C8.2, C9.2, C10.2, C11.2, C12.2, C13.2, C14.2, C15.2, C16.2, C17.2, C18.2, C19.2, C20.2, C21.2, C22.2, C23.2, C24.2, C25.2, C26.2, C27.2, C28.2, C29.2, C30.2, C31.2, C32.2, C33.2, C34.2, C35.2, C36.2, C37.2, C38.2, C39.2, C40.2, IC1.3 (GND), IC1.5 (GND), IC1.21 (GND), IC1.33 (GND(PAD)), IC2.3 (GND), IC2.5 (GND), IC2.21 (GND), IC2.33 (GND(PAD)), IC3.3 (GND), IC3.5 (GND), IC3.21 (GND), IC3.33 (GND(PAD)), IC4.3 (GND), IC4.5 (GND), IC4.21 (GND), IC4.33 (GND(PAD)), P4.1, Q1.1 (S1), Q1.4 (S2), Q2.1 (S1), Q2.4 (S2), Q3.1 (S1), Q3.4 (S2), Q4.1 (S1), Q4.4 (S2), Q5.1 (S1), Q5.4 (S2), Q6.1 (S1), Q6.4 (S2), Q7.1 (S1), Q7.4 (S2), Q8.1 (S1), Q8.4 (S2), Q9.1 (S1), Q9.4 (S2), Q10.1 (S1), Q10.4 (S2), Q11.1 (S1), Q11.4 (S2), Q12.1 (S1), Q12.4 (S2), Q13.1 (S1), Q13.4 (S2), Q14.1 (S1), Q14.4 (S2), Q15.1 (S1), Q15.4 (S2), Q16.1 (S1), Q16.4 (S2), X1.2, X2.2, X3.2, X4.2
unnamed: D1.2 (A), D2.2 (A), D3.2 (A), D4.2 (A), D5.2 (A), D6.2 (A), D7.2 (A), D8.2 (A), R5.2
unnamed: D9.2 (A), D10.2 (A), D11.2 (A), D12.2 (A), D13.2 (A), D14.2 (A), D15.2 (A), D16.2 (A), R6.2
unnamed: D17.2 (A), D18.2 (A), D19.2 (A), D20.2 (A), D21.2 (A), D22.2 (A), D23.2 (A), D24.2 (A), R7.2
unnamed: D25.2 (A), D26.2 (A), D27.2 (A), D28.2 (A), D29.2 (A), D30.2 (A), D31.2 (A), D32.2 (A), R8.2
unnamed: D33.2 (A), D34.2 (A), D35.2 (A), D36.2 (A), D37.2 (A), D38.2 (A), D39.2 (A), D40.2 (A), R9.2
unnamed: D41.2 (A), D42.2 (A), D43.2 (A), D44.2 (A), D45.2 (A), D46.2 (A), D47.2 (A), D48.2 (A), R10.2
unnamed: D49.2 (A), D50.2 (A), D51.2 (A), D52.2 (A), D53.2 (A), D54.2 (A), D55.2 (A), D56.2 (A), R11.2
unnamed: D57.2 (A), D58.2 (A), D59.2 (A), D60.2 (A), D61.2 (A), D62.2 (A), D63.2 (A), D64.2 (A), R12.2
unnamed: D65.2 (A), D66.2 (A), D67.2 (A), D68.2 (A), D69.2 (A), D70.2 (A), D71.2 (A), D72.2 (A), R13.2
unnamed: D73.2 (A), D74.2 (A), D75.2 (A), D76.2 (A), D77.2 (A), D78.2 (A), D79.2 (A), D80.2 (A), R14.2
unnamed: D81.2 (A), D82.2 (A), D83.2 (A), D84.2 (A), D85.2 (A), D86.2 (A), D87.2 (A), D88.2 (A), R15.2
unnamed: D89.2 (A), D90.2 (A), D91.2 (A), D92.2 (A), D93.2 (A), D94.2 (A), D95.2 (A), D96.2 (A), R16.2
unnamed: D97.2 (A), D98.2 (A), D99.2 (A), D100.2 (A), D101.2 (A), D102.2 (A), D103.2 (A), D104.2 (A), R17.2
unnamed: D105.2 (A), D106.2 (A), D107.2 (A), D108.2 (A), D109.2 (A), D110.2 (A), D111.2 (A), D112.2 (A), R18.2
unnamed: D113.2 (A), D114.2 (A), D115.2 (A), D116.2 (A), D117.2 (A), D118.2 (A), D119.2 (A), D120.2 (A), R19.2
unnamed: D121.2 (A), D122.2 (A), D123.2 (A), D124.2 (A), D125.2 (A), D126.2 (A), D127.2 (A), D128.2 (A), R20.2
unnamed: D129.2 (A), D130.2 (A), D131.2 (A), D132.2 (A), D133.2 (A), D134.2 (A), D135.2 (A), D136.2 (A), R21.2
unnamed: D137.2 (A), D138.2 (A), D139.2 (A), D140.2 (A), D141.2 (A), D142.2 (A), D143.2 (A), D144.2 (A), R22.2
unnamed: D145.2 (A), D146.2 (A), D147.2 (A), D148.2 (A), D149.2 (A), D150.2 (A), D151.2 (A), D152.2 (A), R23.2
unnamed: D153.2 (A), D154.2 (A), D155.2 (A), D156.2 (A), D157.2 (A), D158.2 (A), D159.2 (A), D160.2 (A), R24.2
unnamed: D161.2 (A), D162.2 (A), D163.2 (A), D164.2 (A), D165.2 (A), D166.2 (A), D167.2 (A), D168.2 (A), R25.2
unnamed: D169.2 (A), D170.2 (A), D171.2 (A), D172.2 (A), D173.2 (A), D174.2 (A), D175.2 (A), D176.2 (A), R26.2
unnamed: D177.2 (A), D178.2 (A), D179.2 (A), D180.2 (A), D181.2 (A), D182.2 (A), D183.2 (A), D184.2 (A), R27.2
unnamed: D185.2 (A), D186.2 (A), D187.2 (A), D188.2 (A), D189.2 (A), D190.2 (A), D191.2 (A), D192.2 (A), R28.2
unnamed: D193.2 (A), D194.2 (A), D195.2 (A), D196.2 (A), D197.2 (A), D198.2 (A), D199.2 (A), D200.2 (A), R29.2
unnamed: D201.2 (A), D202.2 (A), D203.2 (A), D204.2 (A), D205.2 (A), D206.2 (A), D207.2 (A), D208.2 (A), R30.2
unnamed: D209.2 (A), D210.2 (A), D211.2 (A), D212.2 (A), D213.2 (A), D214.2 (A), D215.2 (A), D216.2 (A), R31.2
unnamed: D217.2 (A), D218.2 (A), D219.2 (A), D220.2 (A), D221.2 (A), D222.2 (A), D223.2 (A), D224.2 (A), R32.2
unnamed: D225.2 (A), D226.2 (A), D227.2 (A), D228.2 (A), D229.2 (A), D230.2 (A), D231.2 (A), D232.2 (A), R33.2
unnamed: D233.2 (A), D234.2 (A), D235.2 (A), D236.2 (A), D237.2 (A), D238.2 (A), D239.2 (A), D240.2 (A), R34.2
unnamed: D241.2 (A), D242.2 (A), D243.2 (A), D244.2 (A), D245.2 (A), D246.2 (A), D247.2 (A), D248.2 (A), R35.2
unnamed: D249.2 (A), D250.2 (A), D251.2 (A), D252.2 (A), D253.2 (A), D254.2 (A), D255.2 (A), D256.2 (A), R36.2
unnamed: Q1.2 (G1), R37.2
unnamed: Q1.5 (G2), R39.2
unnamed: Q2.2 (G1), R41.2
unnamed: Q2.5 (G2), R43.2
unnamed: Q3.2 (G1), R45.2
unnamed: Q3.5 (G2), R47.2
unnamed: Q4.2 (G1), R49.2
unnamed: Q4.5 (G2), R51.2
unnamed: Q5.2 (G1), R53.2
unnamed: Q5.5 (G2), R57.2
unnamed: Q6.2 (G1), R61.2
unnamed: Q6.5 (G2), R65.2
unnamed: Q7.2 (G1), R54.2
unnamed: Q7.5 (G2), R58.2
unnamed: Q8.2 (G1), R62.2
unnamed: Q8.5 (G2), R66.2
unnamed: Q9.2 (G1), R69.2
unnamed: Q9.5 (G2), R73.2
unnamed: Q10.2 (G1), R77.2
unnamed: Q10.5 (G2), R81.2
unnamed: Q11.2 (G1), R70.2
unnamed: Q11.5 (G2), R74.2
unnamed: Q12.2 (G1), R78.2
unnamed: Q12.5 (G2), R82.2
unnamed: Q13.2 (G1), R85.2
unnamed: Q13.5 (G2), R89.2
unnamed: Q14.2 (G1), R93.2
unnamed: Q14.5 (G2), R97.2
unnamed: Q15.2 (G1), R86.2
unnamed: Q15.5 (G2), R90.2
unnamed: Q16.2 (G1), R94.2
unnamed: Q16.5 (G2), R98.2

Notes on the sheet:
Manufacturer: Samtec Inc Part Number: TSM-102-01-L-DV-P-TR Digikey: SAM13279TR-ND
POWER FILTERING
New Manufacturer Vishay Siliconix Manufacturer PN: SI1034CX-T1-GE3 Digikey PN: SI1034CX-T1-GE3TR-ND Old Manufacturer: Toshiba Part Number: SSM3K56FS,LF Digikey: 264-SSM3K56FS,LFTR-ND
BOARD-TO-BOARD CONNECTORS

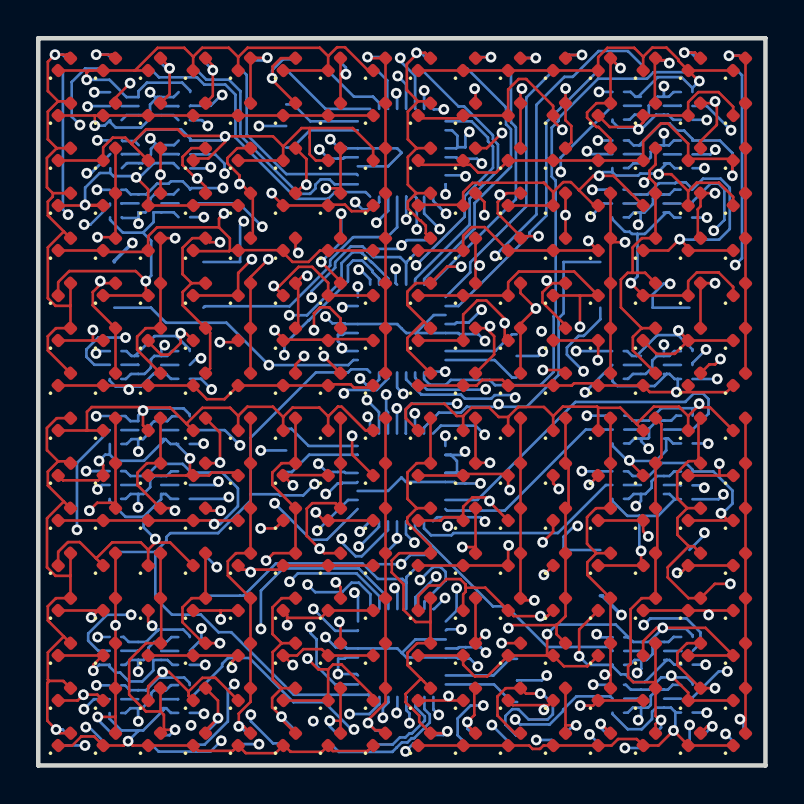
[picture p8: board driver_40mm_atmega.kicad_pcb from above]

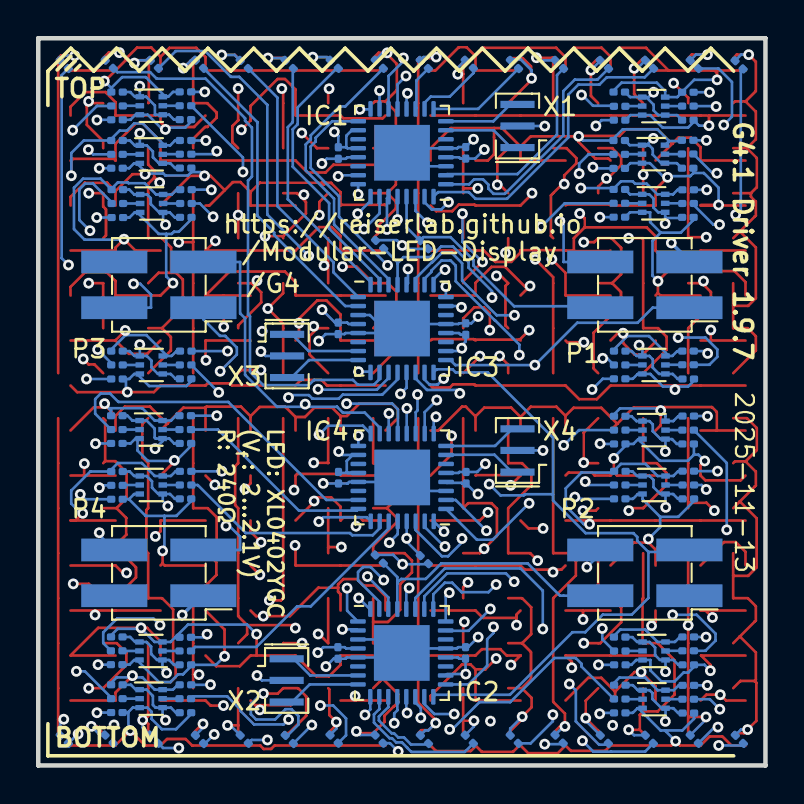
[picture p9: board driver_40mm_atmega.kicad_pcb from below]

Board: 6 copper layers, 40.4 x 40.4 mm, 424 parts (168 on the bottom side), 181 nets.
