reiserlab/LED-Display_G4_Hardware_Driver/(commit log)

2025-05-28 add driver 1.9r5
    [designators.csv, driver_40mm_atmega.kicad_pcb, driver_40mm_atmega.kicad_sch, driver_40mm_v1p9r5_BOM.csv, driver_40mm_v1p9r5_positions.csv]
2025-06-03 fix CPL file
    [driver_40mm_atmega.kicad_pcb, driver_40mm_v1p9r5_positions.csv]
2025-07-30 add STEP export
    [driver_40mm_atmega.step]
2025-07-31 bump to 1.9.6, replace parts that are not available
    [driver_40mm_atmega.kicad_pcb, driver_40mm_atmega.kicad_sch, driver_40mm_atmega.step]
2025-11-13 create driver v1.9.7
    [driver_40mm_atmega.kicad_pcb, driver_40mm_atmega.kicad_sch]
2025-11-13 add schematic and description for v1.9
